shepherdingelectrons/Duncatron/README.md

# Duncatron
8-bit computer from TTL logic chips
