shepherdingelectrons/Duncatron/Duncatron C  compiler and ASM/c files/Test0_While_For.txt

    void main()
    {
       int c=65,d=1;

        while(c<=65+26-1)
        {
       #pragma asm("mov A,%0",c)
       #pragma asm("mov U,A")
       c+=d;
       }
       #pragma asm("mov U,0x0A")
       #pragma asm("mov U,0x0D")

       #pragma asm("mov U,0x46")
       #pragma asm("mov U,0x46")
       #pragma asm("mov U,0x46")
    #pragma asm("mov U,0x0A")
       #pragma asm("mov U,0x0D")
        c=65;
       while(c<=90)
        {
       #pragma asm("mov A,%0",c)
       #pragma asm("mov U,A")
       c+=d;
       }
       #pragma asm("mov U,0x0A")
       #pragma asm("mov U,0x0D")

       #pragma asm("mov U,0x47")
       #pragma asm("mov U,0x47")
       #pragma asm("mov U,0x47")
    #pragma asm("mov U,0x0A")
       #pragma asm("mov U,0x0D")
        c=90;
        for (c=65+26-1;c>=65;c-=1)
        {
        #pragma asm("mov A,%0",c)
        #pragma asm("mov U,A")
        }
       
    #pragma asm("mov U,0x0A")
       #pragma asm("mov U,0x0D")
    }
