shepherdingelectrons/Duncatron/Duncatron C  compiler and ASM/c files/Test1_For_loops.txt

    void main()
    {
        int i,j;
 
        for (i=0;i<10;i++)
        {
        #pragma asm("mov U,0x46")
        }

        for (j=10;j>0;j--)
        {
        #pragma asm("mov U,0x47")
        }
    }
