shepherdingelectrons/Duncatron/Duncatron C  compiler and ASM/asm files/testasm0.txt

test:

mov A,0x00
jz exitwhile2

exitwhile2:
mov A,0x01
halt
