shepherdingelectrons/Duncatron/UART transceiver/Duncatron_ UART.pdf

### VCC

### GND

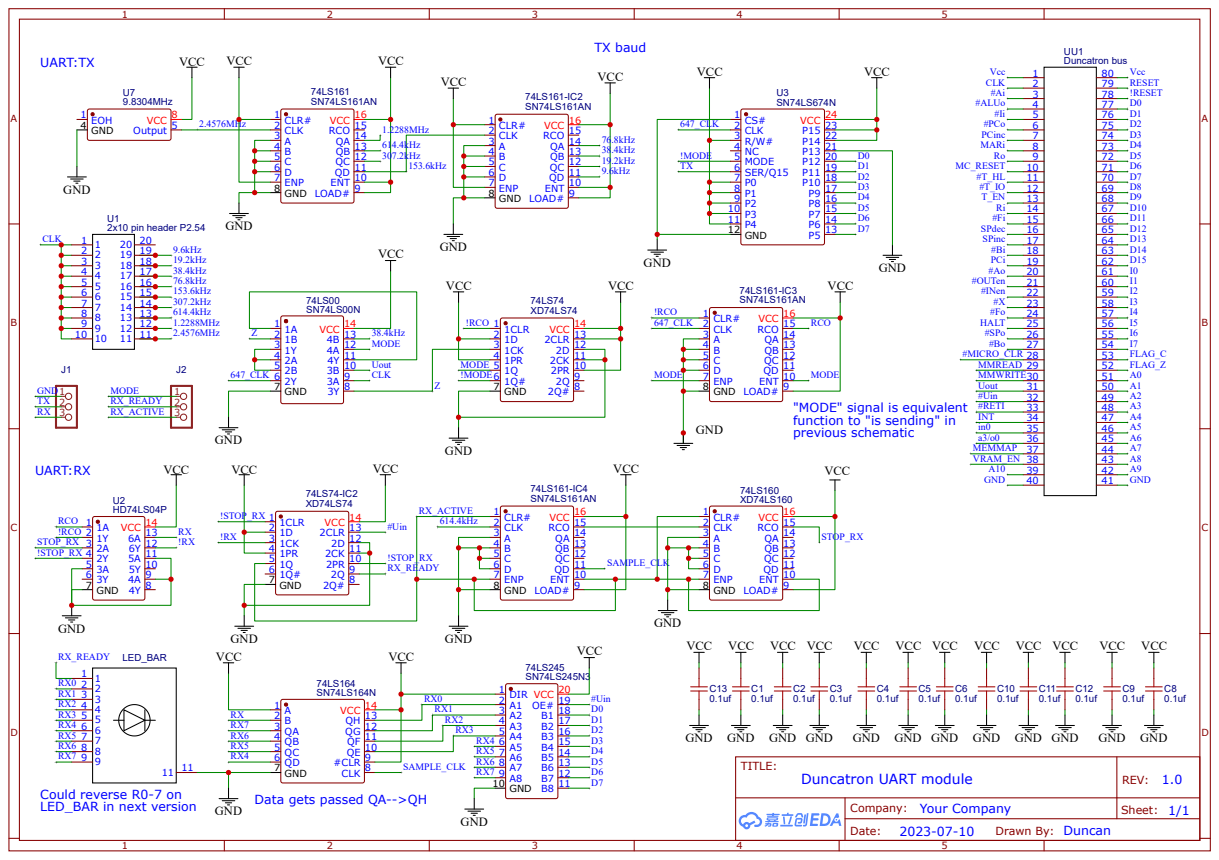
[picture p1: page 1]

"MODE" signal is equivalent
function to "is sending" in
previous schematic
