shepherdingelectrons/Duncatron/Register module/Duncatron_ Register module.pdf

VCC | VCC

## Output demux

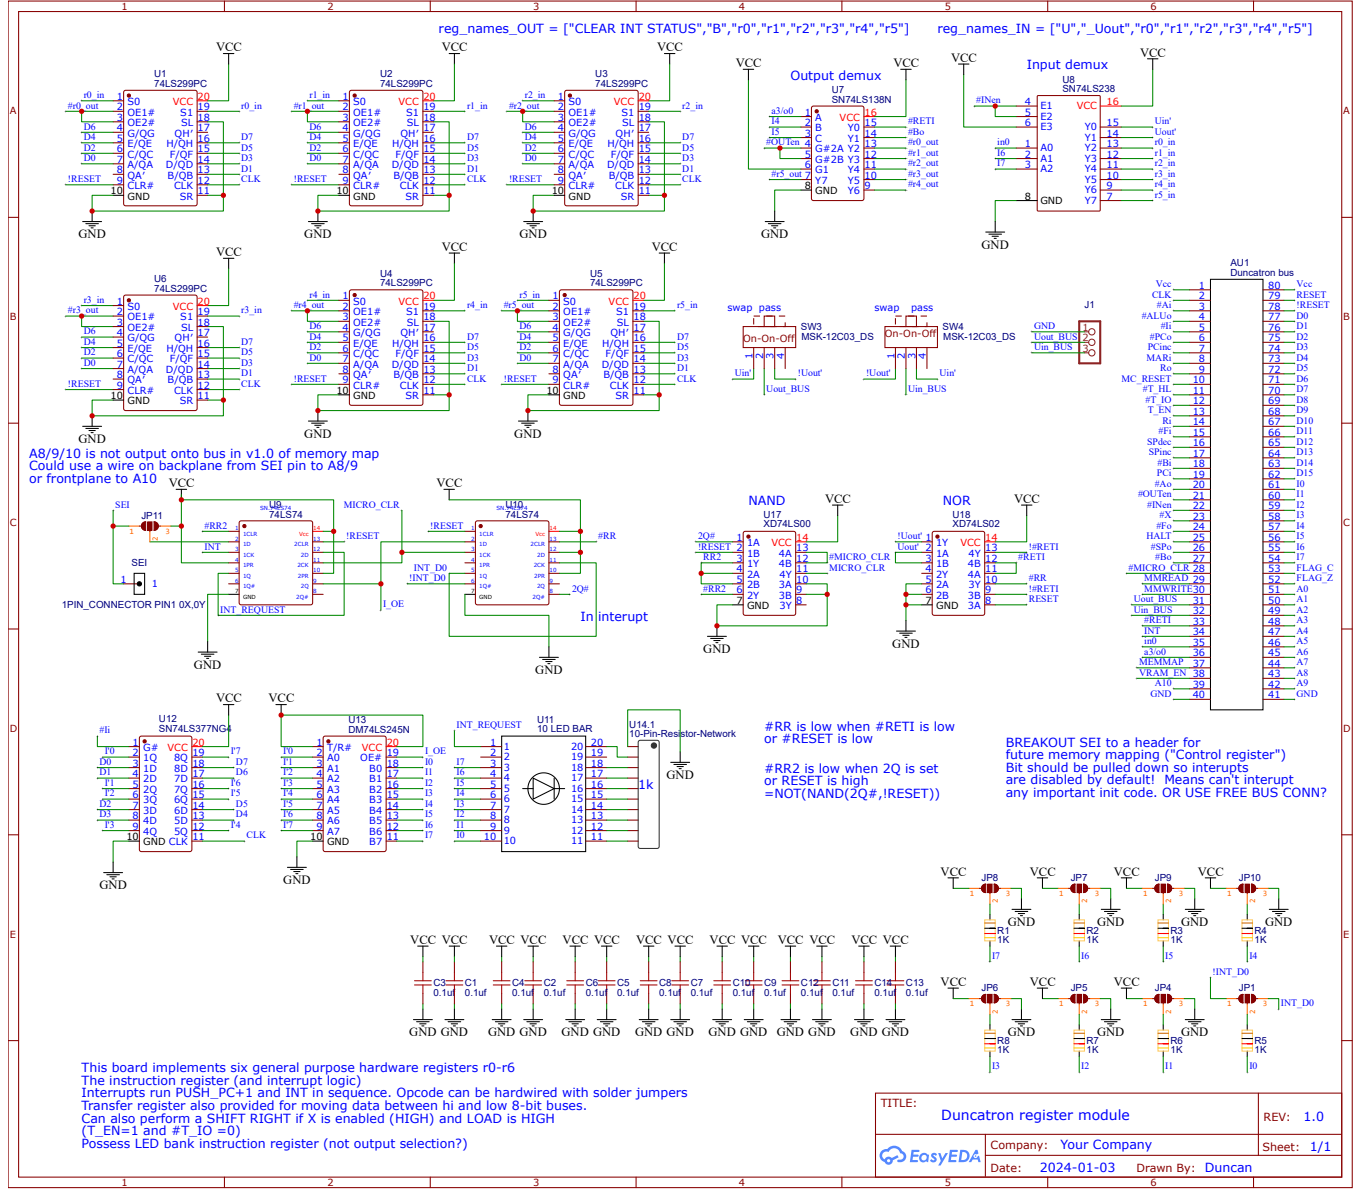
[picture p2: page 1]

A8/9/10 is not output onto bus in v1.0 of memory map
Could use a wire on backplane from SEI pin to A8/9
or frontplane to A10

#RR is low when #RETI is low
or #RESET is low

BREAKOUT SEI to a header for
future memory mapping ("Control register")
Bit should be pulled down so interupts
are disabled by default! Means can't interupt
any important init code. OR USE FREE BUS CONN?

#RR2 is low when 2Q is set
or RESET is high
=NOT(NAND(2Q#,!RESET))

This board implements six general purpose hardware registers r0-r6
The instruction register (and interrupt logic)
Interrupts run PUSH_PC+1 and INT in sequence. Opcode can be hardwired with solder jumpers
Transfer register also provided for moving data between hi and low 8-bit buses.
Can also perform a SHIFT RIGHT if X is enabled (HIGH) and LOAD is HIGH
(T_EN=1 and #T_IO =0)
Possess LED bank instruction register (not output selection?)
