shepherdingelectrons/Duncatron/Memory module/Duncatron_ Memory module.pdf

### VCC

### GND

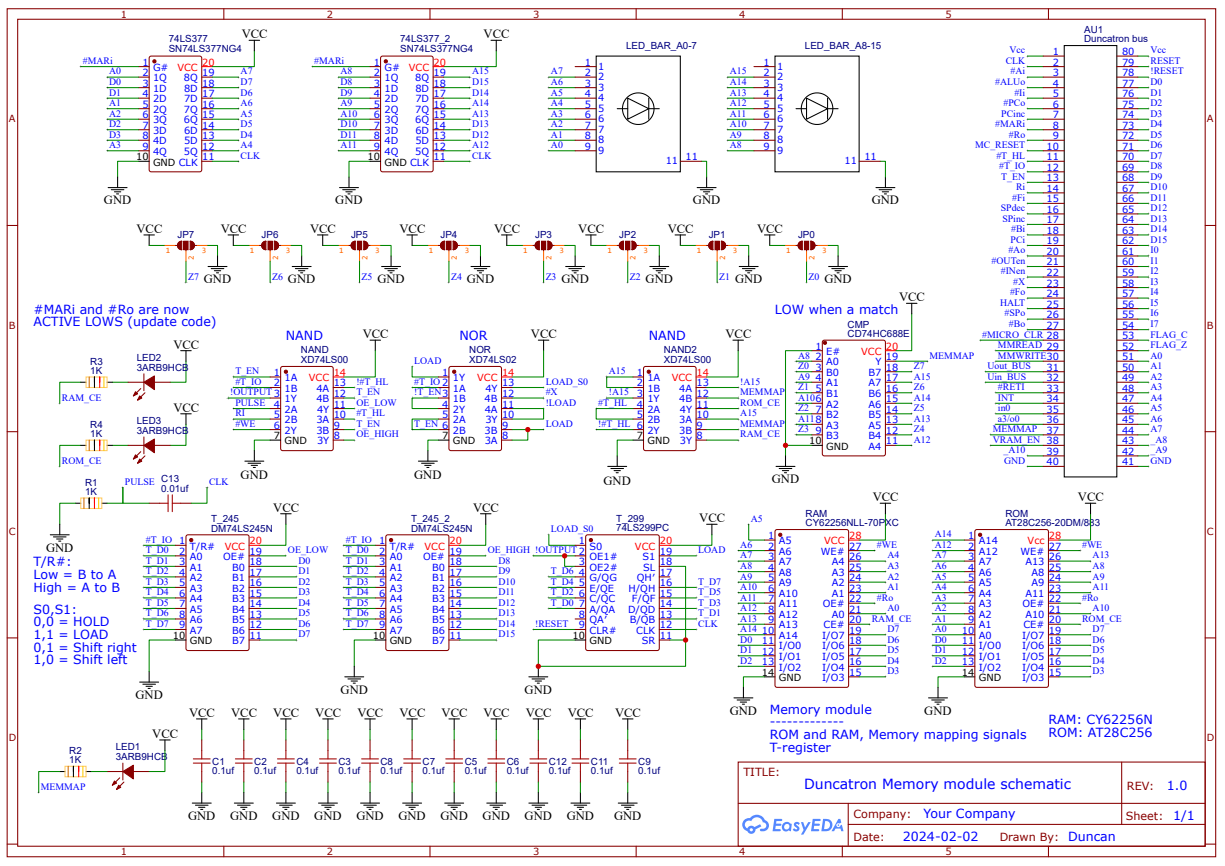
[picture p3: page 1]

#MARi and #Ro are now
ACTIVE LOWS (update code)

Memory module
ROM and RAM, Memory mapping signals
T-register
TITLE:
