shepherdingelectrons/Duncatron/Logic control module/Duncatron_ Py-control board.pdf

## GND

## VCC

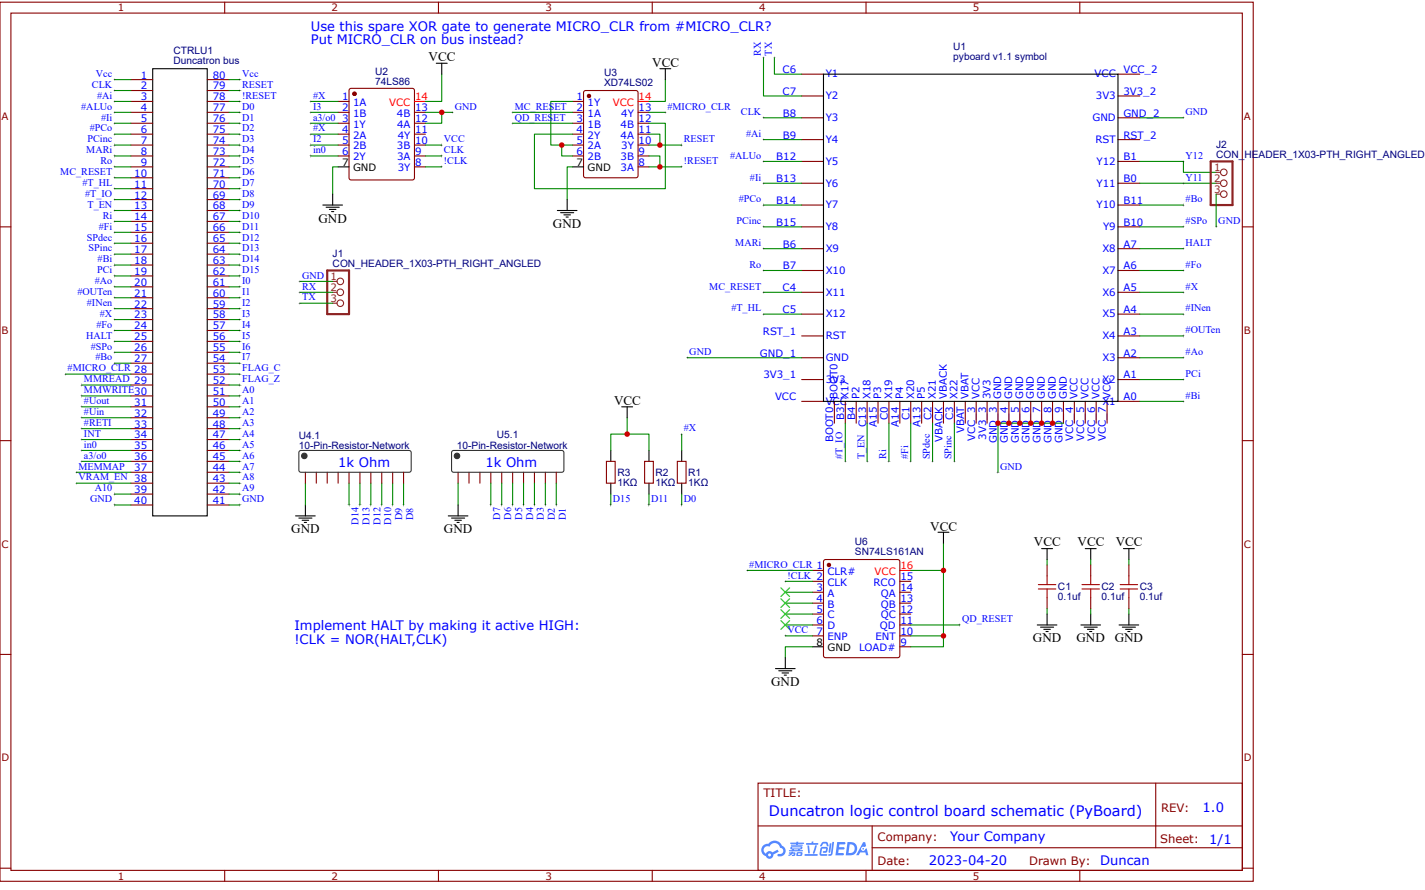
[picture p4: page 1]

Use this spare XOR gate to generate MICRO_CLR from #MICRO_CLR?
Put MICRO_CLR on bus instead?

Implement HALT by making it active HIGH:
!CLK = NOR(HALT,CLK)
