shepherdingelectrons/Duncatron/Base board/Duncatron_ Base board.pdf

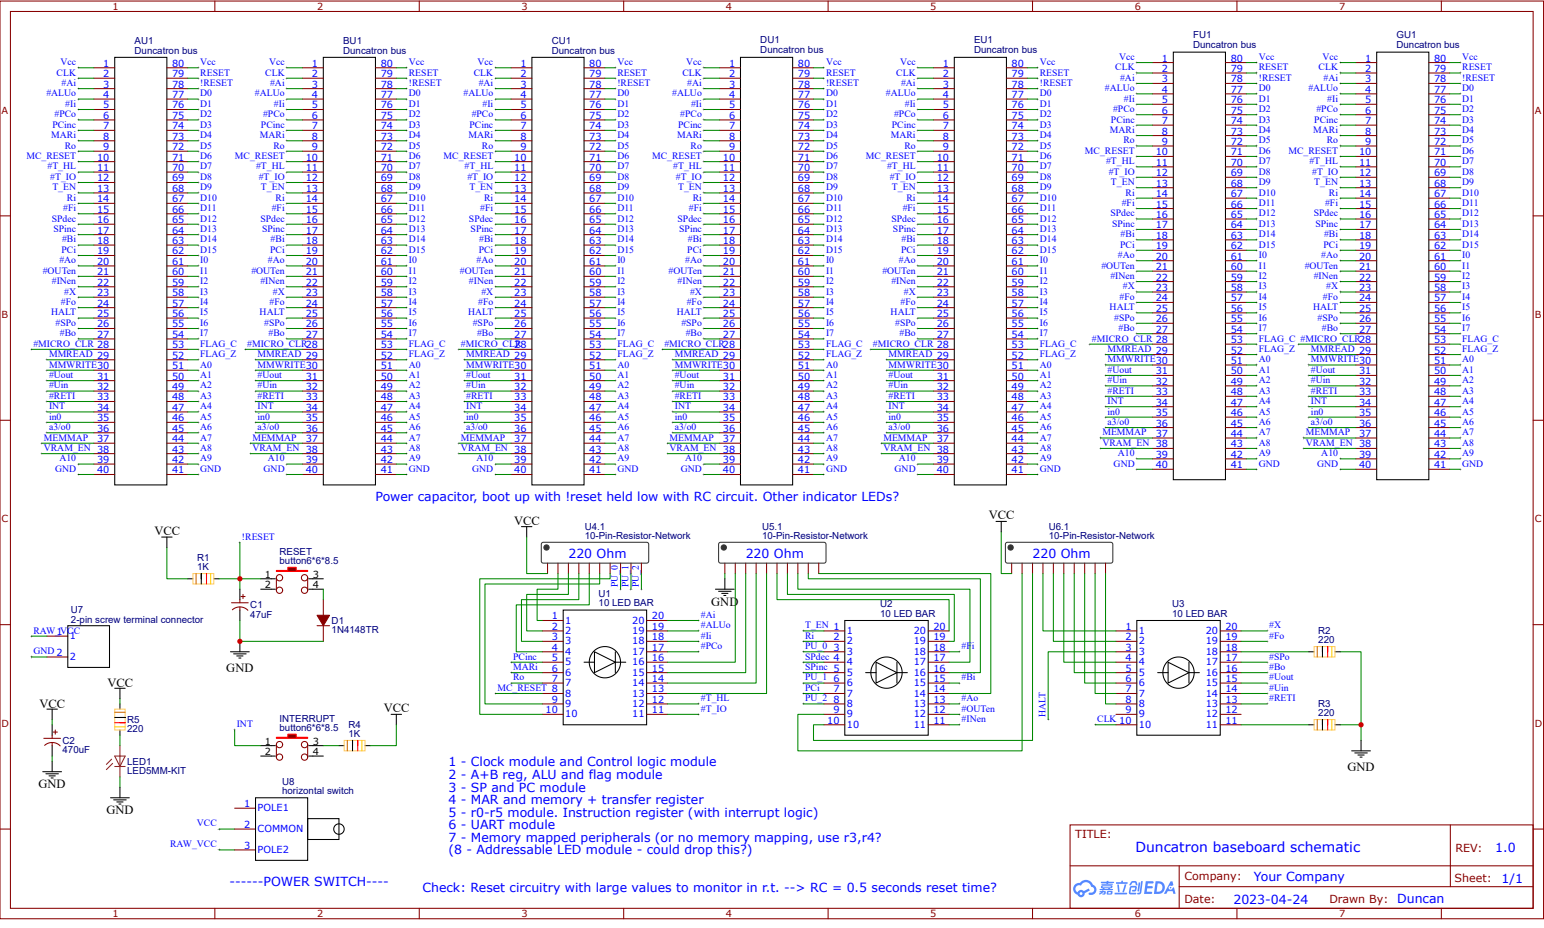
[picture p5: page 1]

Power capacitor, boot up with !reset held low with RC circuit. Other indicator LEDs?

1 - Clock module and Control logic module
2 - A+B reg, ALU and flag module
3 - SP and PC module
4 - MAR and memory + transfer register
5 - r0-r5 module. Instruction register (with interrupt logic)
6 - UART module
7 - Memory mapped peripherals (or no memory mapping, use r3,r4?
(8 - Addressable LED module - could drop this?)

Check: Reset circuitry with large values to monitor in r.t. --> RC = 0.5 seconds reset time?
