shepherdingelectrons/Duncatron/ALU/Duncatron_ ALU.pdf

### VCC

### GND

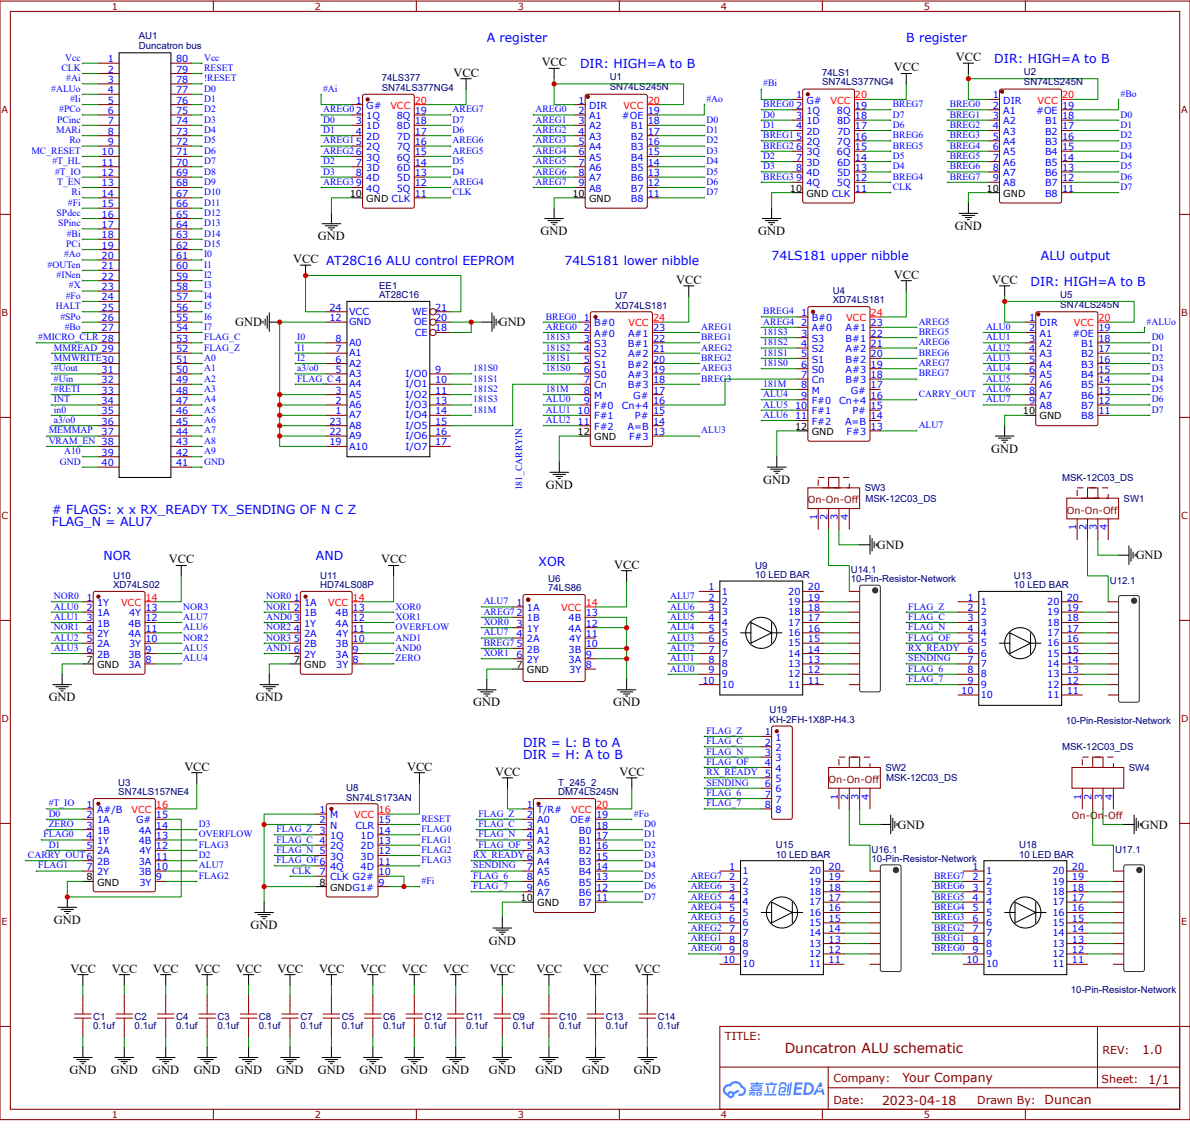
[picture p6: page 1]
