shepherdingelectrons/Duncatron/WS2812 module/WS2812b LED module schematic.pdf

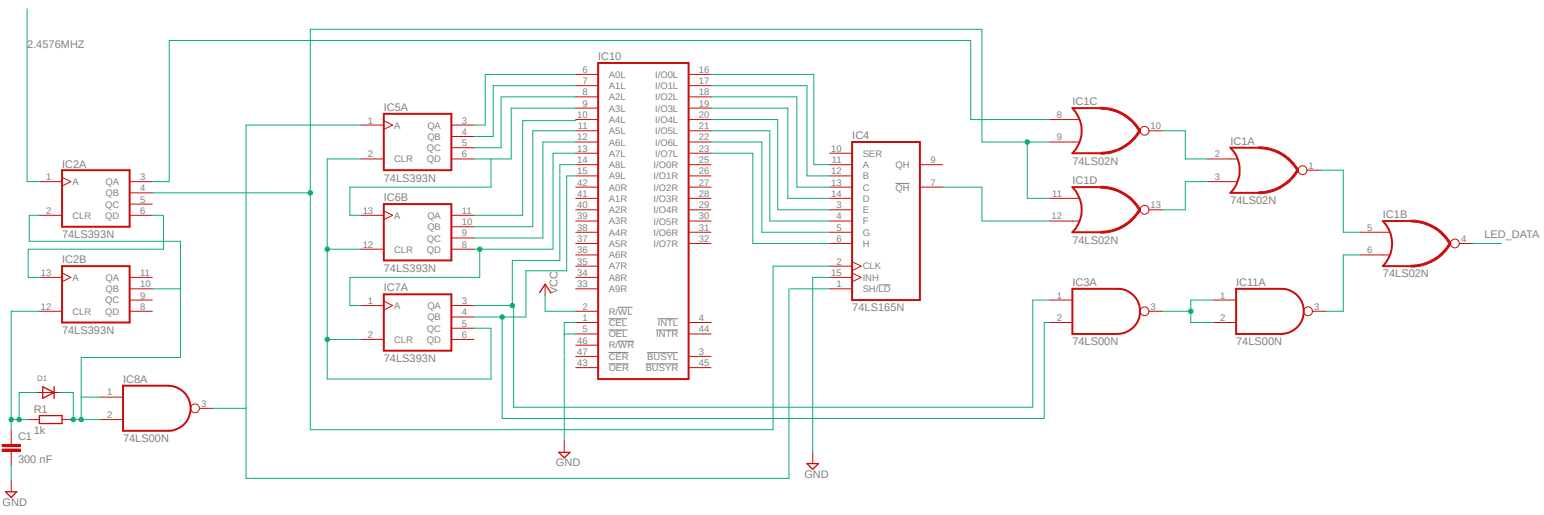
[picture p7: page 1]
