shepherdingelectrons/Duncatron/PC and SP reg/Duncatron_ PC and SP regs.pdf

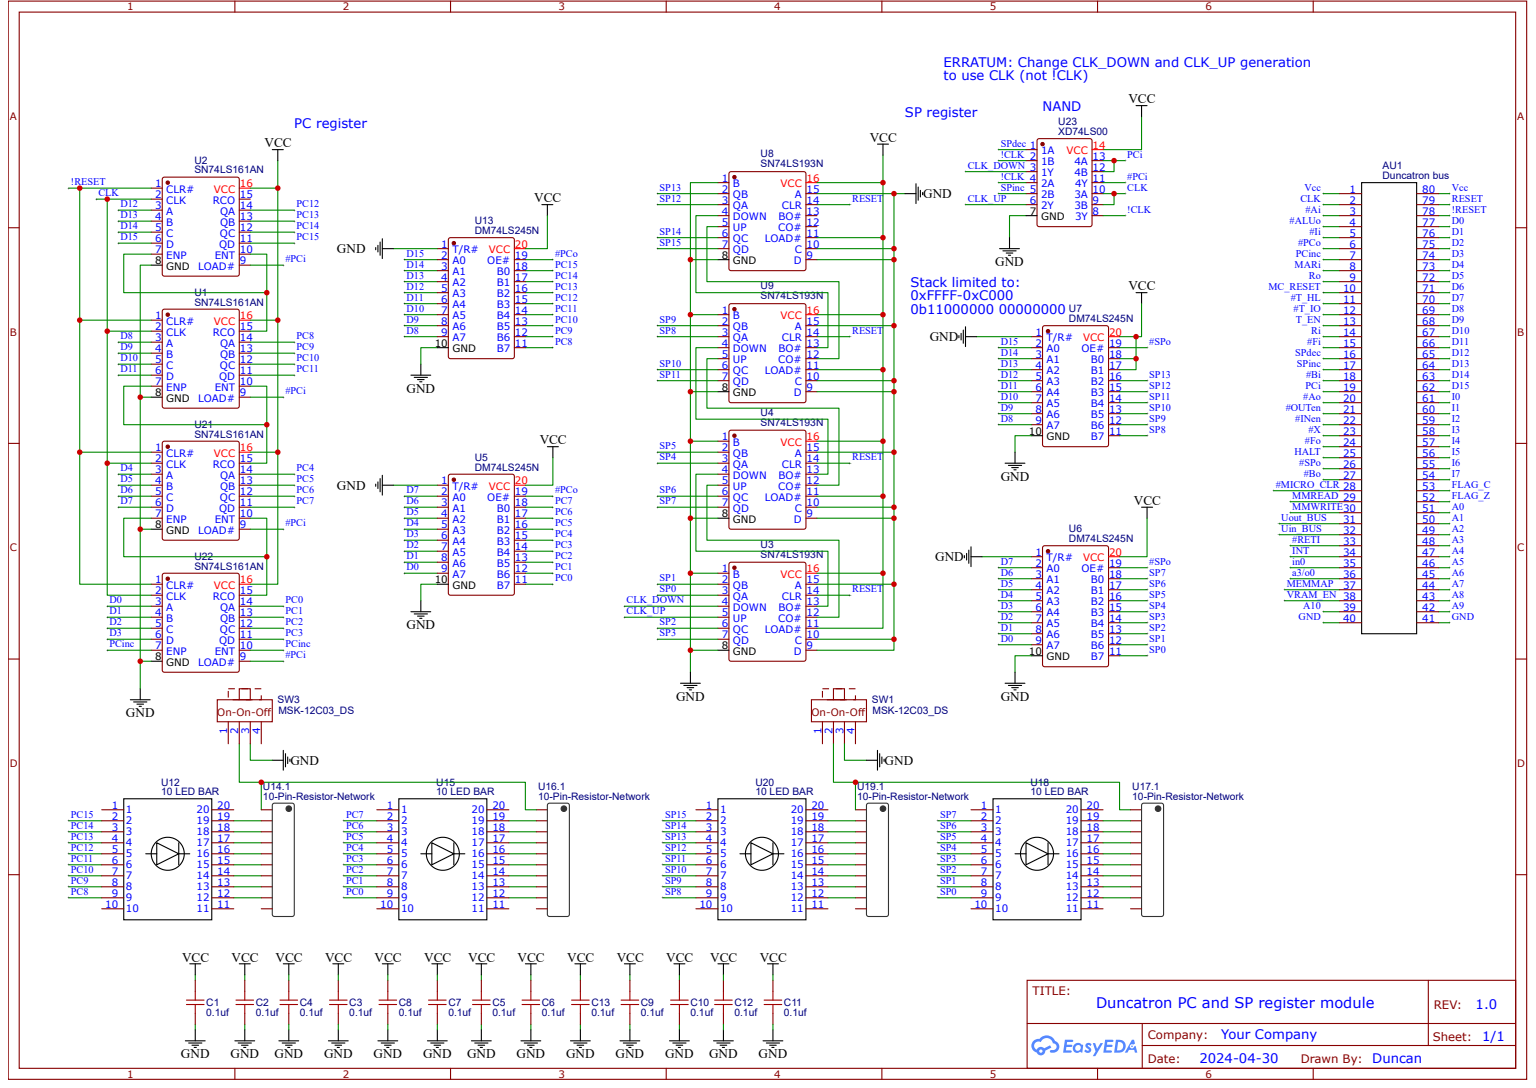
[picture p8: page 1]

ERRATUM: Change CLK_DOWN and CLK_UP generation
to use CLK (not !CLK)

On-On-Off MSK-12C03_DS
