shepherdingelectrons/Duncatron/Logic control module/Duncatron_ ATmega328 logic board.pdf

1k Ohm | 1k Ohm

### RESET Generated on

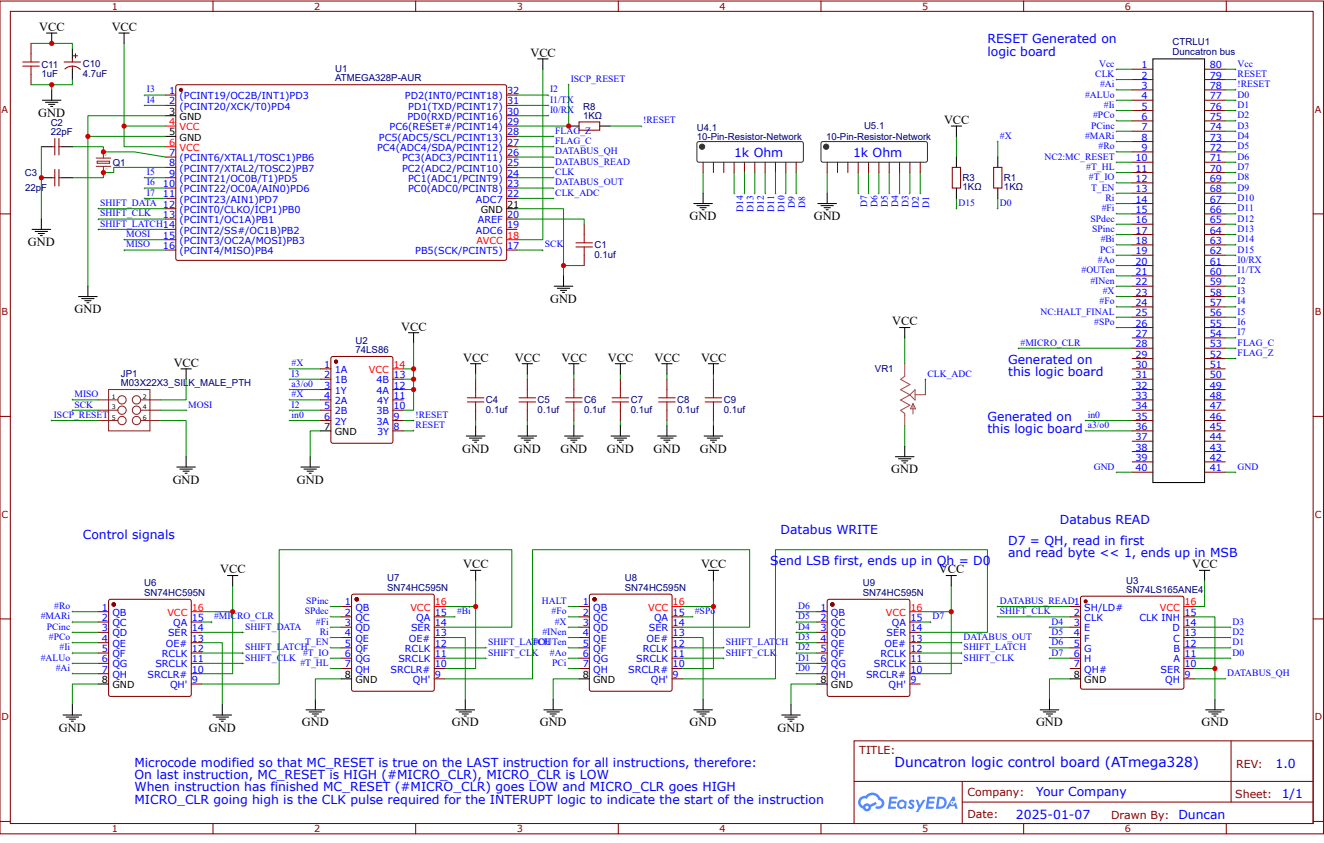
[picture p9: page 1]

D7 = QH, read in first
and read byte << 1, ends up in MSB

Send LSB first, ends up in Qh = D0

Microcode modified so that MC_RESET is true on the LAST instruction for all instructions, therefore:
On last instruction, MC_RESET is HIGH (#MICRO_CLR), MICRO_CLR is LOW
When instruction has finished MC_RESET (#MICRO_CLR) goes LOW and MICRO_CLR goes HIGH
MICRO_CLR going high is the CLK pulse required for the INTERUPT logic to indicate the start of the instruction
