shepherdingelectrons/Duncatron/Logic control module/ATmega328 firmware/main.c

// avrdude -c USBtiny -p m328p -P USB
// avrdude -C USBtiny -p m328p -P USB -U flash:r:"ATMega328 Logic control.hex":i

#include <avr/io.h>
#include <stdio.h>
#include <avr/pgmspace.h>
#include "control_EEPROM0.h"
#include "control_EEPROM1.h"
#include "control_EEPROM2.h"
#include "signals.h"
#include "BurnProgram.h"

#define F_CPU 20000000 // 20 MHz
#define BAUDRATE 19200
#define BAUD_PRESCALLER (((F_CPU / (BAUDRATE * 16UL))) - 1)

//https://www.arduino.cc/reference/tr/language/variables/utilities/progmem/

// ATMega328p control logic sketch

#define set_bit(reg,bit) reg|=(1<<bit)
#define clr_bit(reg,bit) reg&=~(1<<bit)
#define tog_bit(reg,bit) reg^=(1<<bit)
#define set_bit_to_value(reg,bit) reg^=((1<<bit))

// ADC useful definitions

#define SHIFT_DATA_PIN 0	// PB0
#define SHIFT_CLK_PIN 1 	// PB1
#define SHIFT_LATCH_PIN 2	// PB2

#define DATABUS_OUT_PIN 0 //PC0
#define CLK_PIN	1 // PC1
#define DATABUS_READ_PIN 2 // PC2
#define DATABUS_QH_PIN 3 // PC3

//#define IGNORE_ADC 1
//#define USE_UART 1
#define ADC_PIN 7// PORT C Change to 7 on actual board else use PC3 (databus_QH t

#define CLK_PAUSE 0
#define CLK_RUNNING 1
#define CLK_MAX 2
#define CLK_HALT 3

#define DELAY_LOOP(loop_count) for (uint32_t i=0;i<loop_count;i++) { asm("nop");}
#define PAUSE_THRESHOLD 50
#define MAX_THRESHOLD 1000
#define LOOP_MINIMUM 400//40

void test_INS(uint8_t);

void USART_init(void){
	UBRR0H = (uint8_t)(BAUD_PRESCALLER>>8);
	UBRR0L = (uint8_t)(BAUD_PRESCALLER);
	UCSR0B = (1<<RXEN0)|(1<<TXEN0);
	UCSR0C = ((1<<UCSZ00)|(1<<UCSZ01));
	//http://www.avrfreaks.net/forum/usart-interrupts-atmega328p-solved
	
	//UCSR0B |= (1<<RXCIE0); // Enable RX interrupt.
	
	//UART_buffer.read_pos=0;
	//UART_buffer.write_pos=0;
}

uint8_t USART_ready(void)
{
	return (UCSR0A & (1<<RXC0));
}
void USART_send(uint8_t data){	
	while(!(UCSR0A & (1<<UDRE0)));
	UDR0 = data;
}

unsigned char USART_receive(void){
	while(!(UCSR0A & (1<<RXC0))); //loops forever until byte recieved
	return UDR0;
}

void USART_putstring(char* StringPtr)
{
	while(*StringPtr != 0x00){
		USART_send(*StringPtr);
		StringPtr++;
	}
}

void print_bin8(uint8_t number, uint8_t zero_b, uint8_t carriage)
{
	if (zero_b)
	{
		USART_send('0');
		USART_send('b');
	}
	
	for (int8_t i=7; i>=0;i--)
	{
		uint8_t bit = (number>>i)&1;
		USART_send('0'+bit);
	}
	if (carriage)
	{
		USART_send(10);
		USART_send(13);
	}
}

void print_bin16(uint16_t number, uint8_t zero_b, uint8_t carriage)
{
	uint8_t high = number>>8;
	uint8_t low = number & 0xff;
	print_bin8(high,zero_b,0);
	USART_send('|');
	print_bin8(low,0,carriage);
}


void setup_pins()
{
	// PORTD = I0-I7
	DDRD = 0; // set all PORTD pins to INPUTS

	// PB0 = SHIFT_DATA (output)
	// PB1 = SHIFT_CLK (output)
	// PB2 = SHIFT_LATCH (output)
	//DDRB = 0b00000111; // Set PB0-2 for control signal shifting
	DDRB = (1<<SHIFT_LATCH_PIN) | (1<<SHIFT_CLK_PIN) | (1<<SHIFT_DATA_PIN);
	clr_bit(PORTB,SHIFT_DATA_PIN);
	clr_bit(PORTB,SHIFT_CLK_PIN);
	clr_bit(PORTB,SHIFT_LATCH_PIN);	

	// PC0 = DATABUS_OUT (output)
	// PC1 = CLK (output)
	// PC2 = DATABUS_READ (output)
	// PC3 = DATABUS_QH (input)
	// PC4 = FLAG_C (input)
	// PC5 = FLAG_Z (input)
	
	DDRC = (1<<DATABUS_READ_PIN) | (1<<CLK_PIN) | (1<<DATABUS_OUT_PIN); //0b00000111;
	set_bit(PORTC,DATABUS_OUT_PIN); // PC0, DATABUS_OUT = High (active low)	
	clr_bit(PORTC,CLK_PIN); // PC1, CLK
	set_bit(PORTC,DATABUS_READ_PIN); // PC2, DATABUS_READ = High (active low)

	clr_bit(PORTC,ADC_PIN); // disable pull-up resistor for ADC_PIN
	if (ADC_PIN<=5) DIDR0 |= (1<<ADC_PIN); // ADC6 and ADC7 do not have digital input buffers
	
}

void adc_setup()
{
		// ADC setup:
		//https://www.avrfreaks.net/s/topic/a5C3l000000UVHoEAO/t134058
		ADCSRA &=~(1<<ADEN); // disable ADC Enable, to be safe
		
		ADMUX = (1<<REFS0) | ADC_PIN; // AVCC reference voltage, use ADC7
		//ADMUX = (1<<REFS1) | (1<<REFS0) | ADC_PIN; // 1.1V internal ref
		ADCSRA = (1<<ADEN) | (1<<ADPS2)| (1<<ADPS1) | (1<<ADPS0); //Enable ADC, use pre-scaler = 128 (note pre-scalers lower than 4 gave ADC=1023)
		ADCSRA |= (1<<ADSC) ; //Start the conversion
}


inline void shift_out_byte_595(uint8_t shift_byte)
{
	// Shift register 74HC595 clocks into Qa first then Qb, Qc, etc
	// We need to reverse the bit order in define_instructions.py so that Qa is MSB (i.e. #Ai)
	// rather than LSB
	uint8_t i;
	
	for (i=0;i<8;i++)
	{	
		clr_bit(PORTB,0);	//PB0 = Shift data bit pin
		PORTB |= (shift_byte&1);
		set_bit(PORTB,SHIFT_CLK_PIN);
		shift_byte>>=1;
		clr_bit(PORTB,SHIFT_CLK_PIN); // Clock in serial
	}	
}

uint8_t read_databus(void)
{
	uint8_t read_byte,bit;
	
	DELAY_LOOP(1000); // make sure all memory hardware has time to stabilise output
	clr_bit(PORTC, DATABUS_READ_PIN); // grab data bus byte
	set_bit(PORTC, DATABUS_READ_PIN);

	read_byte = 0;
	for (uint8_t i=0; i<7;i++) // get MSB FIRST Qh
	{ // only do this loop 7 times, then a final read - CHECK datasheet!
		bit = (PINC >> DATABUS_QH_PIN) & 1;
		read_byte |= bit;
		set_bit(PORTB,SHIFT_CLK_PIN);
		read_byte <<= 1; // Shift to left
		clr_bit(PORTB,SHIFT_CLK_PIN);
	}
	bit = (PINC >> DATABUS_QH_PIN) & 1;
	read_byte |=bit; // Final Qh read goes into LSB (started as D0 = A position)
	
	return read_byte;
}

void print_hex_nibble(uint8_t nibble)
{
	uint8_t hexchars[] ={'0','1','2','3','4','5','6','7','8','9','A','B','C','D','E','F'};
	USART_send(hexchars[nibble]);
}

void print_hex8(uint8_t number)
{
	uint8_t hi, low;
	
	USART_send('0');
	USART_send('x');
	
	hi = number>>4;
	low = number & 0x0F;
	
	print_hex_nibble(hi);
	print_hex_nibble(low);
}

void print_hex16(uint16_t number)
{
	
	USART_send('0');
	USART_send('x');

	print_hex_nibble(number>>12);
	print_hex_nibble((number>>8)&0x0F);
	print_hex_nibble((number>>4)&0x0F);
	print_hex_nibble(number&0x0F);
}

void print_signals(uint8_t control_byte, uint8_t signal_n)
{
	uint8_t diff_byte;
	uint8_t compares[3]={BYTE0_INACTIVE,BYTE1_INACTIVE,BYTE2_INACTIVE}, compare_byte;
	
	compare_byte=compares[signal_n];
	diff_byte = control_byte ^ compare_byte;
	
	for (uint8_t i=0;i<8;i++)
	{
		if (diff_byte & (1<<i)) // found an active signal at position i
		{
			USART_send('A'+i+signal_n*8);
		}
	}
	
}

void set_signals_data(uint8_t byte0,uint8_t byte1,uint8_t byte2,uint8_t data)
{
	shift_out_byte_595(data); // ends up in databus
	shift_out_byte_595(byte2);
	shift_out_byte_595(byte1);
	shift_out_byte_595(byte0);
	
	set_bit(PORTB,SHIFT_LATCH_PIN);	// Latch output of control signals
	clr_bit(PORTB,SHIFT_LATCH_PIN);
	
	clr_bit(PORTC, DATABUS_OUT_PIN); // Enable databus output
	
	set_bit(PORTC,CLK_PIN); //PC1 high, clock signal latch
	clr_bit(PORTC,CLK_PIN); //PC1 low
	
	set_bit(PORTC, DATABUS_OUT_PIN);  // Switch off databus outputs
}

void set_signals(uint8_t byte0,uint8_t byte1,uint8_t byte2)
{
	shift_out_byte_595(byte2);
	shift_out_byte_595(byte1);
	shift_out_byte_595(byte0);
	
	set_bit(PORTB,SHIFT_LATCH_PIN);	// Latch output of control signals
	clr_bit(PORTB,SHIFT_LATCH_PIN);
	
	set_bit(PORTC,CLK_PIN); //PC1 high, clock signal latch
	clr_bit(PORTC,CLK_PIN); //PC1 low
}

void writeT(uint8_t writebyte)
{
	/*
	def writeT(value):
    T_EN.on() # T_EN = 1 (ENABLE)

    uart.writechar(value&0xff)
    microwait(1E3)
    Uin.on()
    microwait(1E2)
    CLK.on()
    microwait(1E2)
    CLK.off()
    Uin.off()

    T_EN.off()

	*/
	uint8_t byte1;
	
	byte1 = BYTE1_INACTIVE;
	set_bit(byte1, SIGNAL_T_EN);
	set_signals_data(BYTE0_INACTIVE, byte1, BYTE2_INACTIVE, writebyte);
}

void writeMAR(uint16_t addr)
{
	uint8_t high,low;
	uint8_t byte0, byte1;
	
	low = addr & 0xff;
	high = (addr>>8);
	
	writeT(high);
	
	byte0 = BYTE0_INACTIVE;
	byte1 = BYTE1_INACTIVE;
	
	// Need to do some T-register jiggery-pokery but for now just set zeropage-low MAR
	clr_bit(byte0,SIGNAL_MARi); // Set MARi, active low
	set_bit(byte1,SIGNAL_T_EN); // T_EN = 1 (ENABLE)
	set_bit(byte1,SIGNAL_T_IO); // T_IO = 1 (means OUTPUT)
	set_bit(byte1,SIGNAL_T_HL); // T_HL = 1 (HIGH bus)
	
	set_signals_data(byte0,byte1,BYTE2_INACTIVE,low);
}

void writeMEM(uint16_t addr, uint8_t value)
{
	/*
	writeMAR(address)
    uart.writechar(data)
    Ri.on()
    Uin.on()
    microwait(1E3) # sending UART char
    CLK.on()
    microwait(1E2)
    CLK.off()
    microwait(1E2)
    Uin.off()
    Ri.off()
*/
	uint8_t byte0,byte1,byte2;
	writeMAR(addr);
	
	byte0 = BYTE0_INACTIVE;
	byte1 = BYTE1_INACTIVE;
	byte2 = BYTE2_INACTIVE;
	
	set_bit(byte1,SIGNAL_Ri);
	
	shift_out_byte_595(value); // ends up in databus
	shift_out_byte_595(byte2); 
	shift_out_byte_595(byte1);
	shift_out_byte_595(byte0);
	
	set_bit(PORTB,SHIFT_LATCH_PIN);	// Latch output of control signals 
	clr_bit(PORTB,SHIFT_LATCH_PIN);
	
	clr_bit(PORTC, DATABUS_OUT_PIN); // Enable databus output
	
	DELAY_LOOP(10000);
	set_bit(PORTC,CLK_PIN); //PC1 high, clock signal latch
	DELAY_LOOP(10000);
	clr_bit(PORTC,CLK_PIN); //PC1 low 
	
	set_bit(PORTC, DATABUS_OUT_PIN);  // Switch off databus outputs
}

uint8_t readMEM(uint16_t address)
{
	/*def readMEM(address, verbose=False):
    writeMAR(address)
    Ro.on()
    Uout.on()

    microwait(1E2)
    CLK.on()
    microwait(1E2)
    CLK.off()
    microwait(1E3) # Uart output time
    Uout.off()
    Ro.off()*/
	
	uint8_t byte0,byte1,byte2;
	uint8_t mem_byte;
	
	writeMAR(address);
	
	byte0 = BYTE0_INACTIVE;
	byte1 = BYTE1_INACTIVE;
	byte2 = BYTE2_INACTIVE;
	
	clr_bit(byte0,SIGNAL_Ro); // Ro, active low
	
	shift_out_byte_595(byte2); 
	shift_out_byte_595(byte1);
	shift_out_byte_595(byte0);
	
	set_bit(PORTB,SHIFT_LATCH_PIN);	// Latch output of control signals 
	clr_bit(PORTB,SHIFT_LATCH_PIN);
	
	mem_byte = read_databus();
	
	return mem_byte;	
}

void test_INS(uint8_t dir)
{
		// Test Ireg reading
		// if dir==1 then count backwards
		uint8_t Ireg_read, byte0;
		uint16_t Ireg_write,index;
			
		for (index=0;index<256;index++)
		{
			// Set I register on board
			
			Ireg_write = index;
			if (dir==1) Ireg_write = 255-index;
			
			byte0 = BYTE0_INACTIVE;
			clr_bit(byte0,SIGNAL_Ii); //active low
			clr_bit(byte0,SIGNAL_MARi);
			set_signals_data(byte0,BYTE1_INACTIVE,BYTE2_INACTIVE,Ireg_write);
			DELAY_LOOP(1000);
			Ireg_read = PIND;
			if (Ireg_read!=Ireg_write)
			{
				while(1)
				{
					writeMAR((uint16_t) Ireg_read<<8 | Ireg_write);
				}
			}
			DELAY_LOOP(5000);
		}
}

void burndata(const uint8_t *data, uint16_t data_len)
{
	uint8_t read_byte,write_byte;
	uint16_t code_index;

	for (code_index=0;code_index<data_len;code_index++)
	{
		write_byte = pgm_read_byte(data+code_index); // Read what we should have
		read_byte = readMEM(code_index); // Read what we do have
		
		if (read_byte!=write_byte) // If different, write the expected byte
		{
			writeMEM(code_index,write_byte);	// Try one write
			DELAY_LOOP(50000);
			read_byte = readMEM(code_index);
		}
		
		if (read_byte!=write_byte) // Check the write went okay or not
		{
			DELAY_LOOP(2000000);
			writeMAR((uint16_t) read_byte<<8 | write_byte);
			while(1)
			{
				writeMAR((uint16_t) read_byte<<8 | write_byte);
				DELAY_LOOP(500000);
				writeMAR(code_index);
				DELAY_LOOP(500000);
			};
		}	
	}
	
}

void test_stuff(void)
{	
	DELAY_LOOP(2000000); // 2 seconds to let system settle
	
	test_INS(0);
	burndata(BurnProgram,program_code_len);
	}

void burnEEPROM(void)
{
	DELAY_LOOP(2000000); // 2 seconds to let system settle
	
	test_INS(1);
	
	burndata(control2,8192);
	//control_byte0 = pgm_read_byte(control0+address);	
	while(1)	// Success flash!
	{
		writeMAR(0x0ff0);
		DELAY_LOOP(500000);
		writeMAR(0xf00f);
		DELAY_LOOP(500000);
	};
}

int main(void)
{
	uint8_t flags, instruction, microcode_counter=0;
	uint8_t control_byte0, control_byte1, control_byte2;
	uint16_t address; // format = Z | C | m2 | m1 | m0 | I0-I7

	uint16_t clock_ADC; // raw 10-bit ADC value
	char buffer[30];
	uint32_t loop_wait=1000000; // initialise to a slow value, just in case
	uint8_t clock_status = CLK_PAUSE;
	
	setup_pins();
	adc_setup();
	
	set_signals(BYTE0_INACTIVE,BYTE1_INACTIVE,BYTE2_INACTIVE);  //signals OFF
	
	#ifdef USE_UART
	USART_init();
	#endif
	
	test_stuff();

	//burnEEPROM();
	
    while (1) 
    {
		
		if ((ADCSRA & (1<<ADSC))==0) // ADSC bit goes to 0
		{
			#ifdef IGNORE_ADC
				clock_ADC = PAUSE_THRESHOLD; // slowest possible clock
			#else
				clock_ADC = ADC; // 10-bit read
			#endif
			ADCSRA |= (1<<ADSC) ; //Start a conversion
			
			// decide on State based on whether we are paused, running or max running.
			if (clock_ADC<PAUSE_THRESHOLD)
			{
				clock_status = CLK_PAUSE;
				loop_wait=69; // value will be ignored but good to set just in case of a bug
			}
			else if (clock_ADC>MAX_THRESHOLD)
			{
				clock_status = CLK_MAX;
				loop_wait=LOOP_MINIMUM; // We could specify the maximum stable clock
			}
			else
			{
				clock_status = CLK_RUNNING;
				loop_wait = LOOP_MINIMUM + ((MAX_THRESHOLD-(uint32_t) clock_ADC)<<10);
				// clock_ADC = 0, loop_wait = 1023*1024 = 1 Million-ish
				// clock_ADC = 1023, loop_wait = 0;
			}
			/*sprintf(buffer,"%lu\n",loop_wait);
			USART_putstring(buffer);
			USART_send(10);
			USART_send(13);*/
			//ADCSRA |= ADSC; //Start a conversion
		}
		
		if (clock_status==CLK_MAX || clock_status==CLK_RUNNING)
		{
			// shift out bytes here
			instruction = PIND; // reads PORTD
			flags = PINC & 0b110000;
			address = flags<<7 | microcode_counter<<8 | instruction;
			//print_bin16(address,1,1);
			
			control_byte0 = pgm_read_byte(control0+address); // Need to think carefully about order signals emerge from shift register
			control_byte1 = pgm_read_byte(control1+address);
			control_byte2 = pgm_read_byte(control2+address);
			
			#ifdef USE_UART
			print_hex16(address);
			USART_send('*');
			print_hex8(instruction);
			USART_send('|');
			print_hex8(microcode_counter);
			USART_send('|');
			print_hex8(flags);		
			USART_send(':');
			print_hex8(control_byte0);
			USART_send(':');
			print_hex8(control_byte1);
			USART_send(':');
			print_hex8(control_byte2);
			
			USART_send('#');
			print_signals(control_byte0,0);
			print_signals(control_byte1,1);
			print_signals(control_byte2,2);
			
			
			USART_send(10);
			USART_send(13);
			#endif
			
			//if (instruction==191) {while(1){};} // INT found
			shift_out_byte_595(control_byte2);
			shift_out_byte_595(control_byte1);
			shift_out_byte_595(control_byte0);
			
//			DELAY_LOOP(1000);
			set_bit(PORTB,SHIFT_LATCH_PIN);	// Latch output of control signals
//			DELAY_LOOP(1000);
			clr_bit(PORTB,SHIFT_LATCH_PIN);
//			DELAY_LOOP(1000);
	
			/*if(clock_status!=CLK_MAX)
			{ 
				DELAY_LOOP(loop_wait);
			}
			else
			{
				DELAY_LOOP(400);
				}*/

			DELAY_LOOP(loop_wait);
			set_bit(PORTC,CLK_PIN);
			
			microcode_counter++;
			if (control_byte0 & (1<<SIGNAL_MC_reset))
			{
				microcode_counter = 0;
				#ifdef USE_UART
					USART_putstring("MC_RESET");
					USART_send(10);
					USART_send(11);
				#endif
			}
			microcode_counter&=7; // for now, shouldn't be needed though
			
			if (control_byte2 & (1<<SIGNAL_HALT))
			{
				while(1){} // Sit in an infinite loop... HALT
			}
			DELAY_LOOP(loop_wait);
			clr_bit(PORTC,CLK_PIN);
		//	ADCSRA |= ADSC ; //Start a conversion again because we changed a pin on port C
		}
		
		#ifdef USE_UART
		
		if (USART_ready()){
			char uart_byte = USART_receive();
			if (uart_byte=='o')
			{
				clr_bit(PORTC,DATABUS_OUT_PIN);
				DELAY_LOOP(1000000);
				set_bit(PORTC,DATABUS_OUT_PIN);
			}
			if (uart_byte=='r')
			{
				print_bin8(read_databus(),1,1);
			}
			if (uart_byte=='p')
			{
				while(!USART_ready());
				uart_byte = USART_receive();
			}
			shift_out_byte_595(uart_byte);
			set_bit(PORTB,SHIFT_LATCH_PIN);	// Latch output
			clr_bit(PORTB,SHIFT_LATCH_PIN);
			//USART_send(uart_byte);
		}
		#endif
		
		
    }
}
