shepherdingelectrons/Duncatron/Logic control module/ATmega328 firmware/control_EEPROM0.h

const PROGMEM uint8_t control0[] = {
0x47,0x47,0x47,0x47,0x47,0x47,0x47,0x47,0x47,0x47,0x47,0x47,0x47,0x47,0x47,0x47,
0x47,0x47,0x47,0x47,0x47,0x47,0x47,0x47,0x47,0x47,0x47,0x47,0x47,0x47,0x47,0x47,
0x47,0x47,0x47,0x47,0x47,0x47,0x47,0x47,0x47,0x47,0x47,0x47,0x47,0x47,0x47,0x47,
0x47,0x47,0x47,0x47,0x47,0x47,0x47,0x47,0x47,0x47,0x47,0x47,0x47,0x47,0x47,0x47,
0x47,0x47,0x47,0x47,0x47,0x47,0x47,0x47,0x47,0x47,0x47,0x47,0x47,0x47,0x47,0x47,
0x47,0x47,0x47,0x47,0x47,0x47,0x47,0x47,0x47,0x47,0x47,0x47,0x47,0x47,0x47,0x47,
0x47,0x47,0x47,0x47,0x47,0x47,0x47,0x47,0x47,0x47,0x47,0x47,0x47,0x47,0x47,0x47,
0x47,0x47,0x47,0x47,0x47,0x47,0x47,0x47,0x47,0x47,0x47,0x47,0x47,0x47,0x47,0x47,
0x47,0x47,0x47,0x47,0x47,0x47,0x47,0x47,0x47,0x47,0x47,0x47,0x47,0x47,0x47,0x47,
0x47,0x47,0x47,0x47,0x47,0x47,0x47,0x47,0x47,0x47,0x47,0x47,0x47,0x47,0x47,0x47,
0x47,0x47,0x47,0x47,0x47,0x47,0x47,0x47,0x47,0x47,0x47,0x47,0x47,0x47,0x47,0x47,
0x47,0x47,0x47,0x47,0x47,0x47,0x47,0x47,0x47,0x47,0x47,0x47,0x47,0x47,0x47,0x47,
0x47,0x47,0x47,0x47,0x47,0x47,0x47,0x47,0x47,0x47,0x47,0x47,0x47,0x47,0x47,0x47,
0x47,0x47,0x47,0x47,0x47,0x47,0x47,0x47,0x47,0x47,0x47,0x47,0x47,0x47,0x47,0x47,
0x47,0x47,0x47,0x47,0x47,0x47,0x47,0x47,0x47,0x47,0x47,0x47,0x47,0x47,0x47,0x47,
0x47,0x47,0x47,0x47,0x47,0x47,0x47,0x47,0x47,0x47,0x47,0x47,0x47,0x47,0x47,0x47,
0x3b,0x3b,0x3b,0x3b,0x3b,0x3b,0x3b,0x3b,0x3b,0x3b,0x3b,0x3b,0x3b,0x3b,0x3b,0x3b,
0x3b,0x3b,0x3b,0x3b,0x3b,0x3b,0x3b,0x3b,0x3b,0x3b,0x3b,0x3b,0x3b,0x3b,0x3b,0x3b,
0x3b,0x3b,0x3b,0x3b,0x3b,0x3b,0x3b,0x3b,0x3b,0x3b,0x3b,0x3b,0x3b,0x3b,0x3b,0x3b,
0x3b,0x3b,0x3b,0x3b,0x3b,0x3b,0x3b,0x3b,0x3b,0x3b,0x3b,0x3b,0x3b,0x3b,0x3b,0x3b,
0x3b,0x3b,0x3b,0x3b,0x3b,0x3b,0x3b,0x3b,0x3b,0x3b,0x3b,0x3b,0x3b,0x3b,0x3b,0x3b,
0x3b,0x3b,0x3b,0x3b,0x3b,0x3b,0x3b,0x3b,0x3b,0x3b,0x3b,0x3b,0x3b,0x3b,0x3b,0x3b,
0x3b,0x3b,0x3b,0x3b,0x3b,0x3b,0x3b,0x3b,0x3b,0x3b,0x3b,0x3b,0x3b,0x3b,0x3b,0x3b,
0x3b,0x3b,0x3b,0x3b,0x3b,0x3b,0x3b,0x3b,0x3b,0x3b,0x3b,0x3b,0x3b,0x3b,0x3b,0x3b,
0x3b,0x3b,0x3b,0x3b,0x3b,0x3b,0x3b,0x3b,0x3b,0x3b,0x3b,0x3b,0x3b,0x3b,0x3b,0x3b,
0x3b,0x3b,0x3b,0x3b,0x3b,0x3b,0x3b,0x3b,0x3b,0x3b,0x3b,0x3b,0x3b,0x3b,0x3b,0x3b,
0x3b,0x3b,0x3b,0x3b,0x3b,0x3b,0x3b,0x3b,0x3b,0x3b,0x3b,0x3b,0x3b,0x3b,0x3b,0x3b,
0x3b,0x3b,0x3b,0x3b,0x3b,0x3b,0x3b,0x3b,0x3b,0x3b,0x3b,0x3b,0x3b,0x3b,0x3b,0x3b,
0x3b,0x3b,0x3b,0x3b,0x3b,0x3b,0x3b,0x3b,0x3b,0x3b,0x3b,0x3b,0x3b,0x3b,0x3b,0x3b,
0x3b,0x3b,0x3b,0x3b,0x3b,0x3b,0x3b,0x3b,0x3b,0x3b,0x3b,0x3b,0x3b,0x3b,0x3b,0x3b,
0x3b,0x3b,0x3b,0x3b,0x3b,0x3b,0x3b,0x3b,0x3b,0x3b,0x3b,0x3b,0x3b,0x3b,0x3b,0x3b,
0x3b,0x3b,0x3b,0x3b,0x3b,0x3b,0x3b,0x3b,0x3b,0x3b,0x3b,0x3b,0x3b,0x3b,0x3b,0x3b,
0x6f,0x47,0x47,0xec,0x47,0x47,0x47,0xee,0x6e,0xef,0x4f,0x6e,0xef,0x47,0xee,0xef,
0x6f,0x6f,0x6f,0x47,0x6f,0x6f,0x6f,0x47,0x6f,0x6f,0x6f,0xee,0xef,0x47,0x47,0x47,
0x6f,0x6f,0x6f,0x47,0x6f,0x6f,0x6f,0x6f,0xee,0xef,0x4f,0x47,0x47,0x47,0x4f,0x6f,
0x6f,0x6f,0x6f,0x47,0x6f,0x6f,0x6f,0x6f,0xee,0xef,0x47,0x47,0x47,0x4f,0x6f,0x47,
0x47,0xec,0xef,0x6f,0xec,0xec,0xef,0xef,0x47,0xef,0xef,0x47,0xef,0x47,0x47,0x47,
0x6f,0x6f,0x6f,0x6e,0x6f,0x6f,0x6f,0x6f,0x6f,0xef,0xef,0x6e,0x6e,0x4f,0x6f,0x47,
0x6f,0x6f,0x6f,0x6f,0x6f,0x6f,0x6f,0x6f,0xef,0xef,0x47,0x47,0xef,0xef,0x6f,0x47,
0x6f,0x6f,0x6f,0x6f,0x6f,0x6f,0x6f,0x6f,0xef,0xef,0x4f,0x47,0xef,0xef,0xec,0xec,
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
