shepherdingelectrons/Duncatron/Logic control module/ATmega328 firmware/control_EEPROM2.h

const PROGMEM uint8_t control2[] = {
0xae,0xae,0xae,0xae,0xae,0xae,0xae,0xae,0xae,0xae,0xae,0xae,0xae,0xae,0xae,0xae,
0xae,0xae,0xae,0xae,0xae,0xae,0xae,0xae,0xae,0xae,0xae,0xae,0xae,0xae,0xae,0xae,
0xae,0xae,0xae,0xae,0xae,0xae,0xae,0xae,0xae,0xae,0xae,0xae,0xae,0xae,0xae,0xae,
0xae,0xae,0xae,0xae,0xae,0xae,0xae,0xae,0xae,0xae,0xae,0xae,0xae,0xae,0xae,0xae,
0xae,0xae,0xae,0xae,0xae,0xae,0xae,0xae,0xae,0xae,0xae,0xae,0xae,0xae,0xae,0xae,
0xae,0xae,0xae,0xae,0xae,0xae,0xae,0xae,0xae,0xae,0xae,0xae,0xae,0xae,0xae,0xae,
0xae,0xae,0xae,0xae,0xae,0xae,0xae,0xae,0xae,0xae,0xae,0xae,0xae,0xae,0xae,0xae,
0xae,0xae,0xae,0xae,0xae,0xae,0xae,0xae,0xae,0xae,0xae,0xae,0xae,0xae,0xae,0xae,
0xae,0xae,0xae,0xae,0xae,0xae,0xae,0xae,0xae,0xae,0xae,0xae,0xae,0xae,0xae,0xae,
0xae,0xae,0xae,0xae,0xae,0xae,0xae,0xae,0xae,0xae,0xae,0xae,0xae,0xae,0xae,0xae,
0xae,0xae,0xae,0xae,0xae,0xae,0xae,0xae,0xae,0xae,0xae,0xae,0xae,0xae,0xae,0xae,
0xae,0xae,0xae,0xae,0xae,0xae,0xae,0xae,0xae,0xae,0xae,0xae,0xae,0xae,0xae,0xae,
0xae,0xae,0xae,0xae,0xae,0xae,0xae,0xae,0xae,0xae,0xae,0xae,0xae,0xae,0xae,0xae,
0xae,0xae,0xae,0xae,0xae,0xae,0xae,0xae,0xae,0xae,0xae,0xae,0xae,0xae,0xae,0xae,
0xae,0xae,0xae,0xae,0xae,0xae,0xae,0xae,0xae,0xae,0xae,0xae,0xae,0xae,0xae,0xae,
0xae,0xae,0xae,0xae,0xae,0xae,0xae,0xae,0xae,0xae,0xae,0xae,0xae,0xae,0xae,0xae,
0xae,0xae,0xae,0xae,0xae,0xae,0xae,0xae,0xae,0xae,0xae,0xae,0xae,0xae,0xae,0xae,
0xae,0xae,0xae,0xae,0xae,0xae,0xae,0xae,0xae,0xae,0xae,0xae,0xae,0xae,0xae,0xae,
0xae,0xae,0xae,0xae,0xae,0xae,0xae,0xae,0xae,0xae,0xae,0xae,0xae,0xae,0xae,0xae,
0xae,0xae,0xae,0xae,0xae,0xae,0xae,0xae,0xae,0xae,0xae,0xae,0xae,0xae,0xae,0xae,
0xae,0xae,0xae,0xae,0xae,0xae,0xae,0xae,0xae,0xae,0xae,0xae,0xae,0xae,0xae,0xae,
0xae,0xae,0xae,0xae,0xae,0xae,0xae,0xae,0xae,0xae,0xae,0xae,0xae,0xae,0xae,0xae,
0xae,0xae,0xae,0xae,0xae,0xae,0xae,0xae,0xae,0xae,0xae,0xae,0xae,0xae,0xae,0xae,
0xae,0xae,0xae,0xae,0xae,0xae,0xae,0xae,0xae,0xae,0xae,0xae,0xae,0xae,0xae,0xae,
0xae,0xae,0xae,0xae,0xae,0xae,0xae,0xae,0xae,0xae,0xae,0xae,0xae,0xae,0xae,0xae,
0xae,0xae,0xae,0xae,0xae,0xae,0xae,0xae,0xae,0xae,0xae,0xae,0xae,0xae,0xae,0xae,
0xae,0xae,0xae,0xae,0xae,0xae,0xae,0xae,0xae,0xae,0xae,0xae,0xae,0xae,0xae,0xae,
0xae,0xae,0xae,0xae,0xae,0xae,0xae,0xae,0xae,0xae,0xae,0xae,0xae,0xae,0xae,0xae,
0xae,0xae,0xae,0xae,0xae,0xae,0xae,0xae,0xae,0xae,0xae,0xae,0xae,0xae,0xae,0xae,
0xae,0xae,0xae,0xae,0xae,0xae,0xae,0xae,0xae,0xae,0xae,0xae,0xae,0xae,0xae,0xae,
0xae,0xae,0xae,0xae,0xae,0xae,0xae,0xae,0xae,0xae,0xae,0xae,0xae,0xae,0xae,0xae,
0xae,0xae,0xae,0xae,0xae,0xae,0xae,0xae,0xae,0xae,0xae,0xae,0xae,0xae,0xae,0xae,
0xbe,0xae,0xae,0xae,0xae,0xae,0xae,0xa6,0xbe,0xa4,0x2e,0xaa,0xa6,0xae,0xaa,0xac,
0xaa,0xaa,0xaa,0xae,0xaa,0xaa,0xaa,0xae,0xba,0xba,0xba,0xaa,0xaa,0xae,0xae,0xae,
0xaa,0xaa,0xaa,0xae,0xaa,0xaa,0xaa,0xaa,0xaa,0xaa,0x2e,0xae,0xae,0xae,0x2e,0xae,
0xaa,0xaa,0xaa,0xae,0xaa,0xaa,0xaa,0xaa,0xaa,0xaa,0xae,0xae,0xae,0x2e,0xae,0xae,
0xae,0xae,0xae,0xb2,0xae,0xae,0xae,0xa4,0xae,0xa4,0xa2,0xae,0xa2,0xae,0xae,0xae,
0xbe,0xba,0xba,0xaa,0xba,0xba,0xba,0xaa,0xbe,0xa2,0xb2,0xaa,0xaa,0x2e,0xae,0xae,
0xba,0xba,0xba,0xb2,0xba,0xba,0xba,0xaa,0xa2,0xb2,0xae,0xae,0xb2,0xa2,0xae,0xae,
0xba,0xba,0xba,0xb2,0xba,0xba,0xba,0xaa,0xa2,0xb2,0x2e,0xae,0xb2,0xa2,0xae,0xae,
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
