shepherdingelectrons/Duncatron/Duncatron C  compiler and ASM/BurnProgram.h

// File generated automatically by simple_assembler.py
// Source ASM: ..\Building\SystemOS.asm
// File created: 2025-07-08 10:19:01.276943

#define BURN_BINARY 1

uint32_t unique_ID = 0x686ce285; // Stored in EEPROM when burnt to avoid re-burning
uint16_t program_code_len = 2761; // Size in bytes
uint16_t program_start = 0x0; // Starting address in memory

const PROGMEM uint8_t BurnProgram[] = {
0x48,0x07,0x51,0x97,0x00,0x5f,0x01,0x1d,0x0b,0x3a,0x0d,0x13,0x0a,0x13,0x0d,0xbe,
0xf6,0x00,0x94,0xbe,0xf6,0x00,0xc8,0xbe,0xf6,0x00,0x6f,0x48,0x08,0x53,0xbe,0xf6,
0x07,0xc1,0x1f,0x81,0x00,0x02,0x00,0xd3,0x00,0x31,0x48,0x08,0x8e,0xbe,0xf6,0x07,
0xc1,0x48,0x08,0x88,0xbe,0xf6,0x07,0xc1,0xbe,0xf6,0x00,0xc8,0x82,0x82,0x00,0xc3,
0x00,0x13,0x3e,0x07,0xbe,0xf6,0x06,0x82,0xbe,0xf6,0x07,0x59,0x38,0x02,0x01,0xd5,
0x00,0x44,0xbe,0xf6,0x02,0x60,0xb1,0x02,0xff,0xd6,0x00,0x64,0x02,0xfe,0xd6,0x00,
0x00,0xe3,0x00,0x44,0x48,0x08,0xb5,0xbe,0xf6,0x07,0xc1,0xfe,0xe3,0x00,0x00,0x48,
0x08,0xc0,0xbe,0xf6,0x07,0xc1,0x48,0x08,0xe4,0xbe,0xf6,0x07,0xc1,0x48,0x09,0x18,
0xbe,0xf6,0x07,0xc1,0x48,0x09,0x4d,0xbe,0xf6,0x07,0xc1,0x48,0x09,0x82,0xbe,0xf6,
0x07,0xc1,0x3d,0xfd,0x1d,0x9f,0x3b,0x81,0x01,0x1d,0xbf,0x3b,0x81,0x01,0x1d,0xdf,
0x3b,0x81,0x01,0x1d,0xff,0x3b,0x81,0x01,0x1d,0x01,0x3a,0x13,0x1d,0x22,0x3a,0x16,
0x1d,0x44,0x3a,0x19,0x1d,0x68,0x3a,0x1c,0x1d,0x00,0x3a,0x11,0x3a,0x14,0x3a,0x17,
0x3a,0x1a,0x3a,0x1d,0x3a,0x21,0x3d,0xfd,0x1d,0x00,0x3a,0x10,0x48,0x01,0x5d,0xbe,
0xf6,0x01,0x02,0x48,0x00,0xae,0xbe,0xf6,0x01,0x02,0x48,0x00,0x57,0xbe,0xf6,0x01,
0x02,0x48,0x00,0x2e,0xbe,0xf6,0x01,0x02,0xbe,0xf6,0x00,0x94,0x3d,0xfd,0x93,0x2c,
0x10,0x9b,0x3b,0x81,0x01,0x1b,0x9b,0x3b,0x81,0x01,0x1d,0x90,0x2c,0x10,0x9b,0x3b,
0x81,0x01,0x1b,0xbd,0x0f,0xbb,0x80,0x2c,0x10,0x9b,0x3b,0x81,0x01,0x93,0xf0,0xf0,
0xf0,0xf0,0x0f,0x1b,0xe7,0xe7,0xe7,0xe7,0x9b,0x3b,0x81,0x01,0x1d,0x90,0x2c,0x10,
0x9b,0x3b,0x81,0x01,0x3d,0xfd,0x01,0x66,0x01,0x76,0x01,0x84,0x01,0x8d,0x01,0x99,
0x01,0xa5,0x01,0xb5,0x01,0xbb,0x01,0xc0,0x01,0xd4,0x01,0xe0,0x02,0x0b,0x02,0x1c,
0x02,0x2d,0x02,0x3e,0x02,0x4f,0x02,0xff,0x02,0xb7,0x02,0xde,0x03,0x79,0x03,0xd8,
0x04,0x78,0x02,0xb3,0x07,0x38,0x05,0xd0,0x05,0xf1,0x06,0x1f,0x00,0x00,0x00,0x00,
0x00,0x00,0x00,0x00,0x00,0x00,0x68,0x65,0x78,0x20,0x30,0x78,0x23,0x23,0x23,0x23,
0x20,0x30,0x78,0x23,0x23,0x00,0x77,0x20,0x30,0x78,0x23,0x23,0x23,0x23,0x20,0x30,
0x78,0x23,0x23,0x00,0x72,0x20,0x30,0x78,0x23,0x23,0x23,0x23,0x00,0x63,0x61,0x6c,
0x6c,0x20,0x30,0x78,0x23,0x23,0x23,0x23,0x00,0x6c,0x6f,0x61,0x64,0x20,0x30,0x78,
0x23,0x23,0x23,0x23,0x00,0x61,0x64,0x64,0x63,0x6d,0x64,0x20,0x30,0x78,0x23,0x23,
0x23,0x23,0x20,0x2a,0x00,0x72,0x65,0x73,0x65,0x74,0x00,0x68,0x65,0x6c,0x70,0x00,
0x6d,0x69,0x64,0x69,0x20,0x30,0x78,0x23,0x23,0x20,0x30,0x78,0x23,0x23,0x20,0x30,
0x78,0x23,0x23,0x00,0x70,0x6c,0x61,0x79,0x20,0x30,0x78,0x23,0x23,0x23,0x23,0x00,
0x70,0x6c,0x61,0x79,0x20,0x6f,0x66,0x66,0x00,0x00,0x00,0x00,0x00,0x00,0x00,0x00,
0x00,0x00,0x00,0x00,0x00,0x00,0x00,0x00,0x00,0x00,0x00,0x00,0x00,0x00,0x00,0x00,
0x00,0x00,0x00,0x00,0x00,0x00,0x00,0x00,0x00,0x00,0x00,0x00,0x00,0x00,0x00,0x00,
0x00,0x00,0x00,0x00,0x00,0x00,0x00,0x00,0x00,0x00,0x00,0x00,0x00,0x00,0x00,0x00,
0x00,0x00,0x00,0x00,0x00,0x00,0x00,0x00,0x00,0x00,0x00,0x00,0x00,0x00,0x00,0x00,
0x00,0x00,0x00,0x00,0x00,0x00,0x00,0x00,0x00,0x00,0x00,0x00,0x00,0x00,0x00,0x00,
0x00,0x00,0x00,0x00,0x00,0x00,0x00,0x00,0x00,0x00,0x00,0x00,0x00,0x00,0x00,0x00,
0x00,0x00,0x00,0x00,0x00,0x00,0x00,0x00,0x00,0x00,0x00,0x00,0x00,0x00,0x00,0x00,
0x82,0x01,0x26,0xc3,0x00,0x67,0x49,0xac,0x67,0x47,0xa5,0x6e,0x82,0x82,0x00,0xc5,
0x02,0xbe,0xf6,0x07,0xf9,0x38,0x02,0x00,0x8e,0x99,0xd5,0x02,0x96,0xac,0xf4,0xb1,
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
