shepherdingelectrons/Duncatron/Logic control module/ATmega328 firmware/signals.h

#define SIGNAL_Ai 0 	//Active LOW 
#define SIGNAL_ALUo 1	//Active LOW
#define SIGNAL_Ii 2		//Active LOW
#define SIGNAL_PCo 3	//Active LOW
#define SIGNAL_PCinc 4
#define SIGNAL_MARi 5	//Active LOW
#define SIGNAL_Ro 6		//Active LOW
#define SIGNAL_MC_reset 7

#define BYTE0_INACTIVE 0b01101111

#define SIGNAL_T_HL 0
#define SIGNAL_T_IO 1
#define SIGNAL_T_EN 2
#define SIGNAL_Ri 3
#define SIGNAL_Fi 4		//Active LOW
#define SIGNAL_SPdec 5
#define SIGNAL_SPinc 6
#define SIGNAL_Bi 7		//Active LOW

#define BYTE1_INACTIVE 0b10010000

#define SIGNAL_PCi 0
#define SIGNAL_Ao 1		//Active LOW
#define SIGNAL_OUTen 2	//Active LOW
#define SIGNAL_INen 3	//Active LOW
#define SIGNAL_X 4
#define SIGNAL_Fo 5		//Active LOW
#define SIGNAL_HALT 6
#define SIGNAL_SPo 7	//Active LOW

#define BYTE2_INACTIVE 0b10101110
