shepherdingelectrons/Duncatron/(commit log)

2021-03-29 Update main.py
    Removed explicit control of LED_CE signal - it is not neded and should be pulled low continuously.
2021-05-15 corrected ALU EEPROM mistake
    [main.py]
2021-05-17 Removed label from schematic PDFs
2021-05-17 Create MAR schematic.pdf
2021-05-17 Update MAR schematic.pdf
2021-09-19 Update MAR code and schematic
2022-05-11 Modules tweaked to enable pipelining of compile, assemble, simulate process
2022-05-23 Added compilation, assembly and simulation testing pipeline
2023-05-07 Update SP reg.pdf
    updated SP schematic
2023-05-07 Update ALU and flag register schematic.pdf
    correct flag direction signal
2023-08-05 Fixed CALL and INT microcode
    [SimulateCPU.py]
2024-06-30 added binary burning feature
    [assembler.py, main.py, simple_assembler.py]
2024-07-07 Schematics updated
2024-08-02 clear UART register before main()
2024-09-03 Added print_hex function
2024-11-27 Aligned Fi behaviour with PCB T_IO signal direction
2024-11-29 myConsole variable name corrected
    [SimulateCPU.py]
2025-01-23 show labels added to assemble
2025-01-24 Changed MC_RESET behaviour
    The final microcode of instructions all contain MC_RESET signal, hardware is changed accordingly.
    define_instructions.py now outputs EEPROM control signals into C headers for ATMega328 control logic board
2025-02-11 Fixed ADC issue
2025-04-17 Added BurnProgram.h file creation
    [simple_assembler.py]
2025-05-05 Logic board firmware update
2025-05-14 corrected end of string bug in cmp_str_special
    [SystemOS.asm]
2025-05-25 call and reset functions added
    [SystemOS.asm]
2025-06-24 Added print to console support
2025-06-27 catch error for parsing data bytes
    [simple_assembler.py]
2025-12-10 Print binary coded decimal
    Uses double dabble algorithm
2025-12-10 DS1302 SPI functions
2025-12-10 Function to reverse bit-order
    Useful for LSB SPI devices like DS1302 communication
    [reverse.asm]
2025-12-11 corrected clock burst function
    [SPI.asm]
2026-01-02 SD card mounting
2026-01-20 Additional SD card mounting commands
2026-01-23 refactor SPI command send
2026-03-07 SPI DS1302 RTI and 7-digit display
